KRISUUUU/esp32-s3-voice-satellite/3d_models/pokrywa.stl

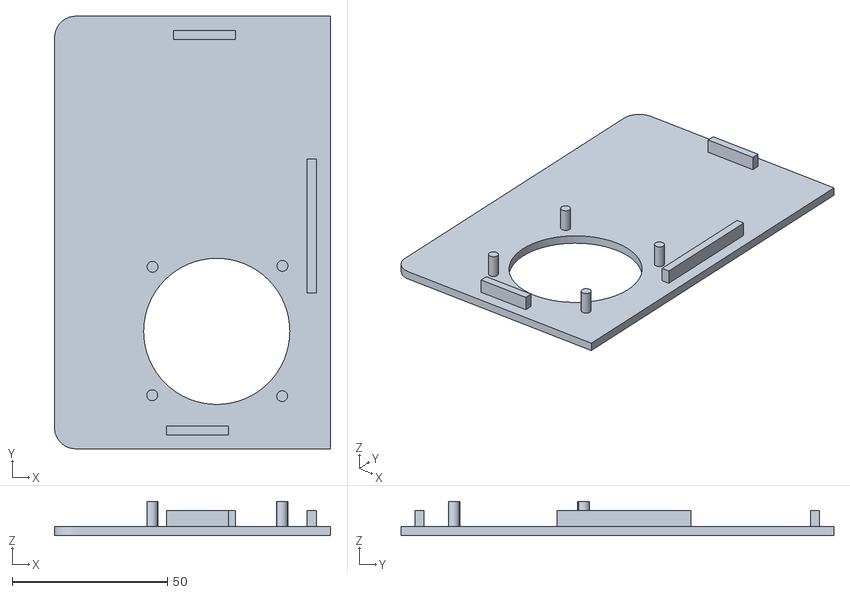
[picture p2: CAD file, 2026-01-05]
3d_models/pokrywa.stl
88.8 x 139.2 x 11.0
