KRISUUUU/esp32-s3-voice-satellite/3d_models/maskownica.stl

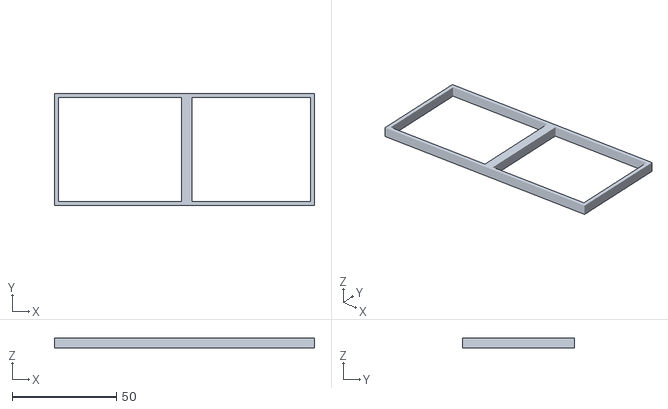
[picture p3: CAD file, 2026-01-05]
3d_models/maskownica.stl
125.0 x 54.0 x 5.00
