KRISUUUU/esp32-s3-voice-satellite/3d_models/glosnik.stl

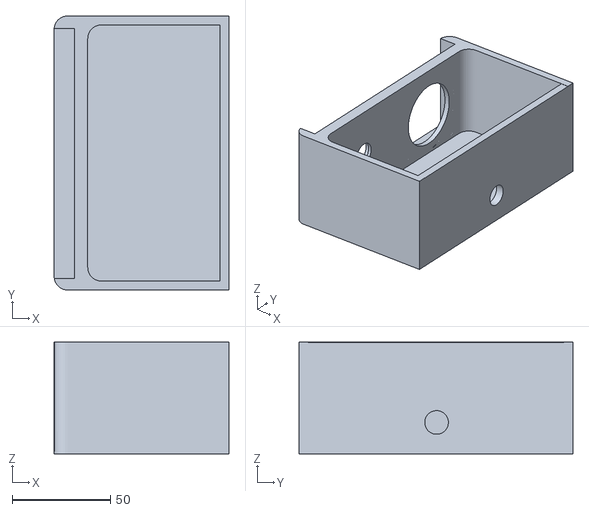
[picture p4: CAD file, 2026-01-05]
3d_models/glosnik.stl
88.9 x 139.2 x 56.8
