KRISUUUU/esp32-s3-voice-satellite/(commit log)

2026-01-05 Initial commit (clean start)
    [glosnik.stl, maskownica.stl, pokrywa.stl]
2026-01-15 Fix CI build by removing external partition table URL (#4)
    [voice_assistant.yaml]
